LittleMoon9Sun/Pico-16-Key-Hitbox/亚克力外壳/加工说明.md

# 亚克力加工说明

请结合 `01_切割图_DWG` 内的图纸确认轮廓、开孔、铣槽及方向，正式加工前先核对比例和尺寸。

| 图纸 | 板材和工艺 |
| --- | --- |
| 01 | 4 mm，正面轻磨砂、背面透明；背面反印 UV，白墨打底。图中多数封闭矩形为开孔，其中一个指定方孔不切穿并保持透明、不喷绘；开孔有铣槽，具体区域请结合图纸与厂家确认。 |
| 02 | 4 mm 普通透明亚克力，图中框选区域正常开孔。 |
| 03 | 3 mm 普通透明亚克力，图中框选区域正常开孔。 |
| 04 | 2mm，发光板：参考 `05_发光板切割图.dwg`，选用透光扩散材料，厚度与叠层配合请先试装确认，使用前请核对轮廓、孔位和比例。 |
| 05 | 2 mm，正面透明磨砂，背面 UV 喷绘并白墨打底；图中框选区域正常开孔。 |

喷绘图案与开孔留白需另行提供并与厂家确认；本文不包含喷绘素材；使用前请核对轮廓、孔位和比例。

**本项目文件由 AI 协助整理，可能存在遗漏或错误，请在使用、加工或制作前自行审核并核对相关内容。**
