LittleMoon9Sun/Pico-16-Key-Hitbox/说明文档/开源协议说明.md

# 使用许可说明

本项目中作者有权授权的 PCB 设计、亚克力外壳设计及说明文档采用 **CC BY-NC 4.0（署名—非商业性使用 4.0 国际许可协议）**。完整法律条款见 [Creative Commons 官方协议](https://creativecommons.org/licenses/by-nc/4.0/legalcode.en)，中文概要见[协议说明](https://creativecommons.org/licenses/by-nc/4.0/deed.zh-hans)。

在遵守协议的前提下，使用者可以为非商业目的复制、分享和修改这些文件。分享时应合理署名、提供许可链接，并注明是否修改。商业使用需要另行取得权利人的许可。改编作品不强制采用相同许可，但原作品仍受其原有许可条件约束。

## 第三方内容

- PCB 工程包含动漫人物丝印；第三方插画及其他非作者拥有授权权利的内容不属于上述许可范围。使用这些内容还需取得相应权利人的许可。
- 喷绘图、动漫插图和启动图素材不属于本项目提供的授权素材。
- GP2040-CE 是独立项目，固件及其源码遵循[官方项目](https://github.com/OpenStickCommunity/GP2040-CE)的许可，本项目不重新授权。

本许可不赋予作者无权授权的权利，也不授予专利或商标权。涉及第三方素材的文件能否公开、复制或用于制板，应根据实际授权确认；仅将素材排除在许可之外，并不等于获得公开传播它的许可。

本项目采用非商业限制，属于供非商业用途的公开分享，不符合 [OSHWA 的开源硬件定义](https://oshwa.org/definition/)中允许商业使用的要求。
