LittleMoon9Sun/Pico-16-Key-Hitbox/说明文档/材料与成本.md

# 材料与成本参考

下表为制作时记录的采购规格与金额，单位均为人民币（元）。不同时间、购买数量、型号、优惠券和运费都会使价格变化；表中仅供复刻时估算和查找规格，并非实时售价或每台的固定成本。

**本项目文件由 AI 协助整理，可能存在遗漏或错误，请在使用、加工或制作前自行审核并核对相关内容。**

## 组装材料

| 类别 | 规格或型号 | 装机数量 | 采购数量 | 记录金额 | 备注 |
| --- | --- | ---: | ---: | ---: | --- |
| 主控 | Raspberry Pi Pico（RP2040） | 1 | 1 | 13.00 | 另有运费 3 元 |
| 轴体 | 凯华知春 CHOC 矮轴 | 16 | 18 | 53.50 | 多购 2 颗作备件 |
| 轴座 | 凯华 CHOC 热插拔底座 | 16 | 20 | 10.00 | 多购 4 个作备件 |
| RGB 灯 | 3528 反贴 RGB 灯珠 | 64 | 100 | 9.00 | 灯珠方向与串接顺序需实测 |
| 显示屏 | 0.96 英寸 128×64 OLED | 1 | 1 | 9.48 | I²C：SDA/GP0、SCL/GP1 |
| 轻触开关 | 6×6×9 mm、4 脚直插 | 5 | 20 | 2.20 | 另配 8×8 mm 硅胶帽 |
| 轻触开关帽 | 8×8 mm 硅胶按键帽 | 5 | 6 | 7.10 | 另有运费 5 元 |
| 电阻 | 22 Ω、0805 | 2 | 100 | 3.30 | USB 数据线串联位置；22 Ω 为阻值，0805 为封装 |
| 键帽 | 键帽 | 16 | 16 | 59.00 | 实际装配选更便宜键盘，另有运费 10 元 |
| 结构件 | 304 子母铆钉 M4×15 | 按装配需要 | 20 | 2.53 | 长度应和板材叠层实物核对 |
| PCB | 定制 PCB | 1 套 | 3 块 | 12.40 | **3 块合计，使用新人优惠券；无优惠券不能按此价格估算** |
| 外壳 | 亚克力板件 | 1 套 | 1 批 | 130.00 | 见 `亚克力外壳/加工说明.md` |
| 发光层 | 扩散板/发光板材料 | 1 套 | 1 批 | 15.00 | 厚度须与实物装配确认 |
| 线材 | Type-C 数据线 | 1 | 1 | 15.80 | 用于连接主控 |

## 制作工具与耗材

| 项目 | 规格 | 记录金额 |
| --- | --- | ---: |
| 按键分布打印 | ×2 | 0.40 |
| 电烙铁 | 60 W 内热式 | 34.80 |
| 焊锡丝 | 63Sn37Pb，50 g | 15.90 |
| 助焊膏 | 维修佬 559 | 8.68 |
| 洗板水 | — | 12.70 |
| 焊接练习件 | — | 14.68 |
| 隔热垫 | — | 7.51 |
| 镊子 | — | 2.89 |

## 估算口径

| 口径 | 金额 | 包含内容 |
| --- | ---: | --- |
| 表内全部历史记录 | 473.07 | 全部内容 |
| 可复用工具与耗材 | 97.56 | 电烙铁、焊锡、助焊膏、洗板水、练习件、隔热垫、镊子与打印费 |

实际复刻时，先按“板上/装配材料”逐项下单，再按是否已有工具决定是否加入第三项。PCB 的 12.40 元是三块板的优惠价，不能用它代表单块或常规制板价格。

**本项目文件由 AI 协助整理，可能存在遗漏或错误，请在使用、加工或制作前自行审核并核对相关内容。**
