LittleMoon9Sun/Pico-16-Key-Hitbox/(list of files, cad)

Other CAD files:
亚克力外壳/01_切割图_DWG/04_2MM发光板切割图.dwg
亚克力外壳/02_3D结构模型_DWG/01-3D顶板-最上层-铣槽版.dwg
亚克力外壳/01_切割图_DWG/02 4MM普通透明亚克力.dwg
亚克力外壳/02_3D结构模型_DWG/02-3D顶板-限位板.dwg
亚克力外壳/01_切割图_DWG/05 2MM正面透明磨砂背面UV喷涂白墨打底 亚克力.dwg
亚克力外壳/02_3D结构模型_DWG/04-3D底板-发光板.dwg
亚克力外壳/01_切割图_DWG/01 4MM正面轻磨砂背面透明反印UV喷涂白墨打底 亚克力（有铣槽和喷绘留白特殊需求）.dwg
亚克力外壳/02_3D结构模型_DWG/05-3D底板-最下层.dwg
亚克力外壳/01_切割图_DWG/03 3MM普通透明亚克力.dwg
亚克力外壳/02_3D结构模型_DWG/03-3D底板-PCB下层.dwg
