LittleMoon9Sun/Pico-16-Key-Hitbox/电路板/03_PCB布局预览_PDF/Hitbox_PCB布局预览1.pdf

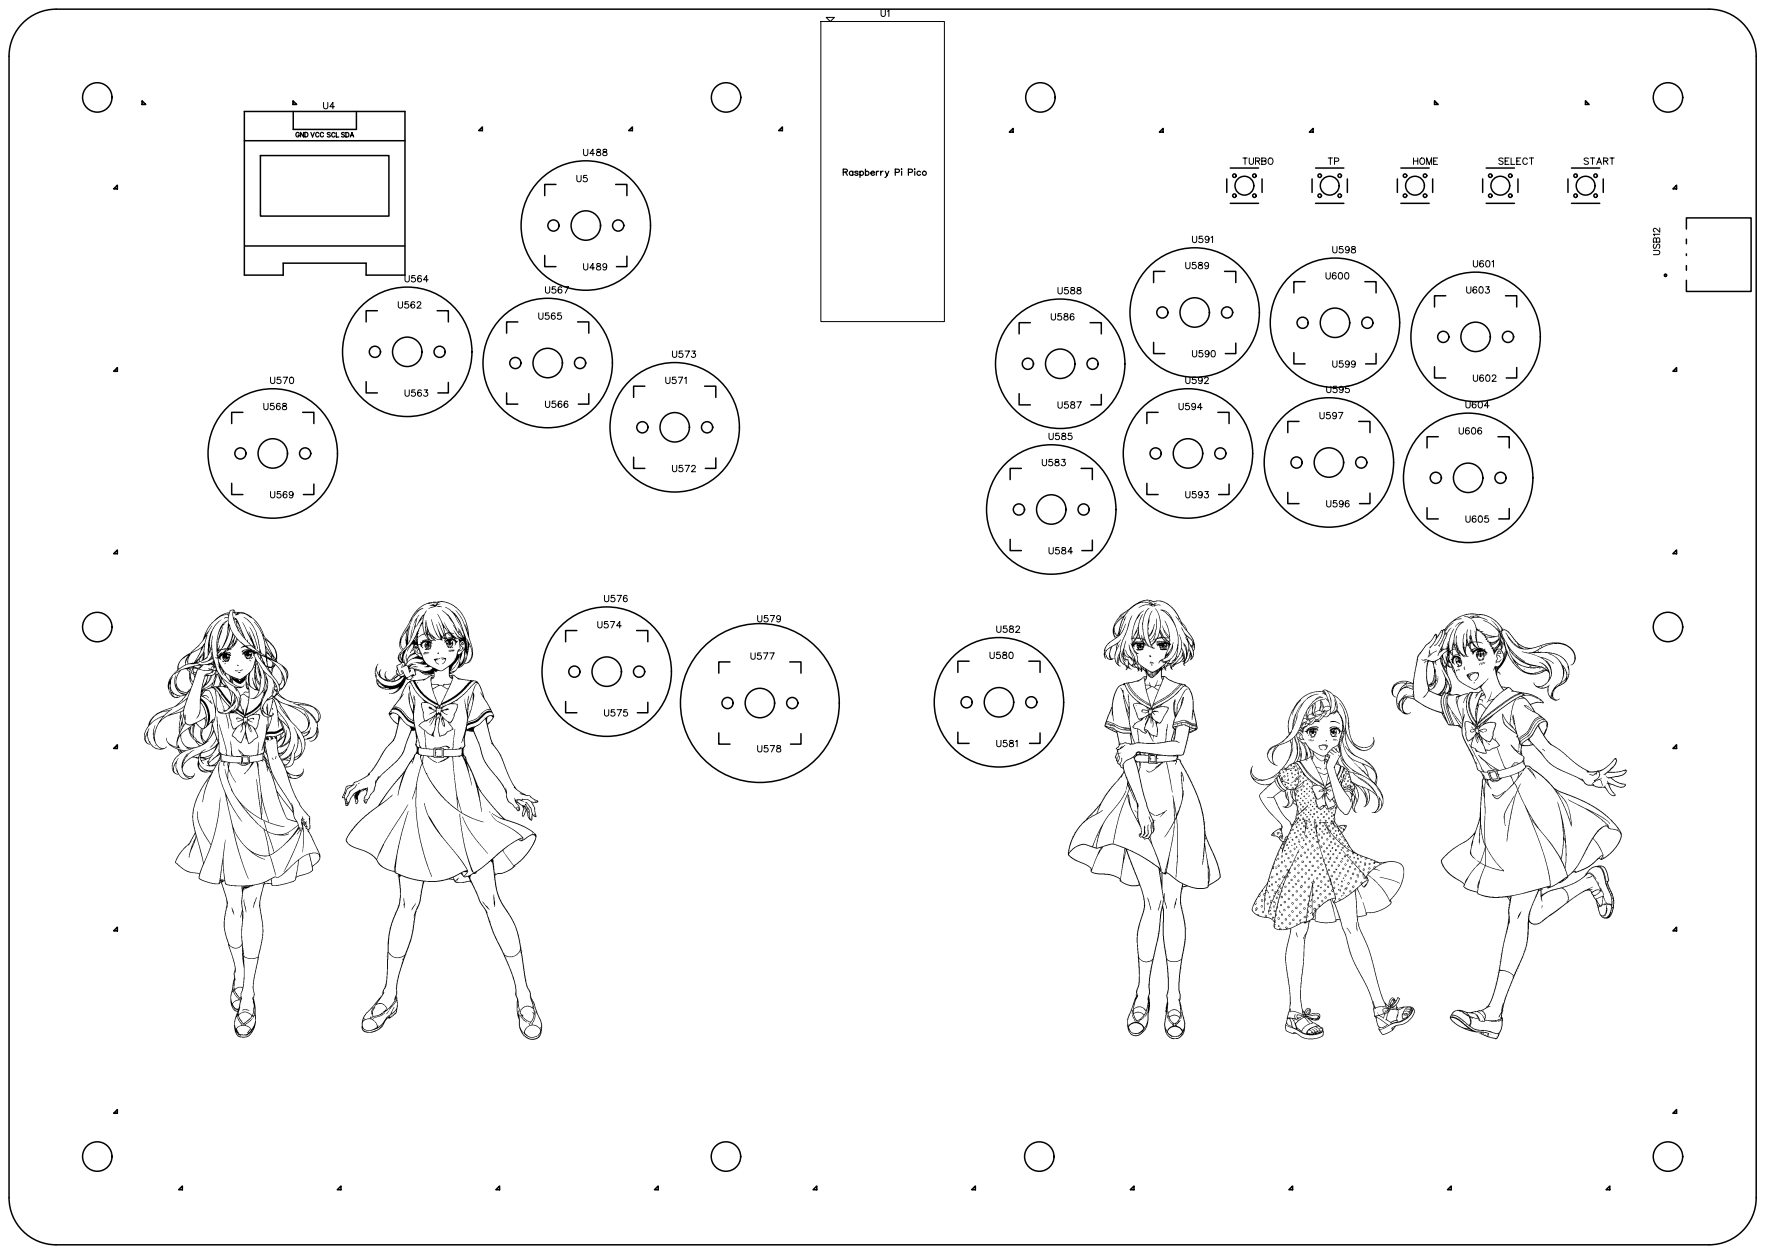
[picture p2: page 1]
