LittleMoon9Sun/Pico-16-Key-Hitbox/电路板/03_PCB布局预览_PDF/Hitbox_PCB布局预览2.pdf

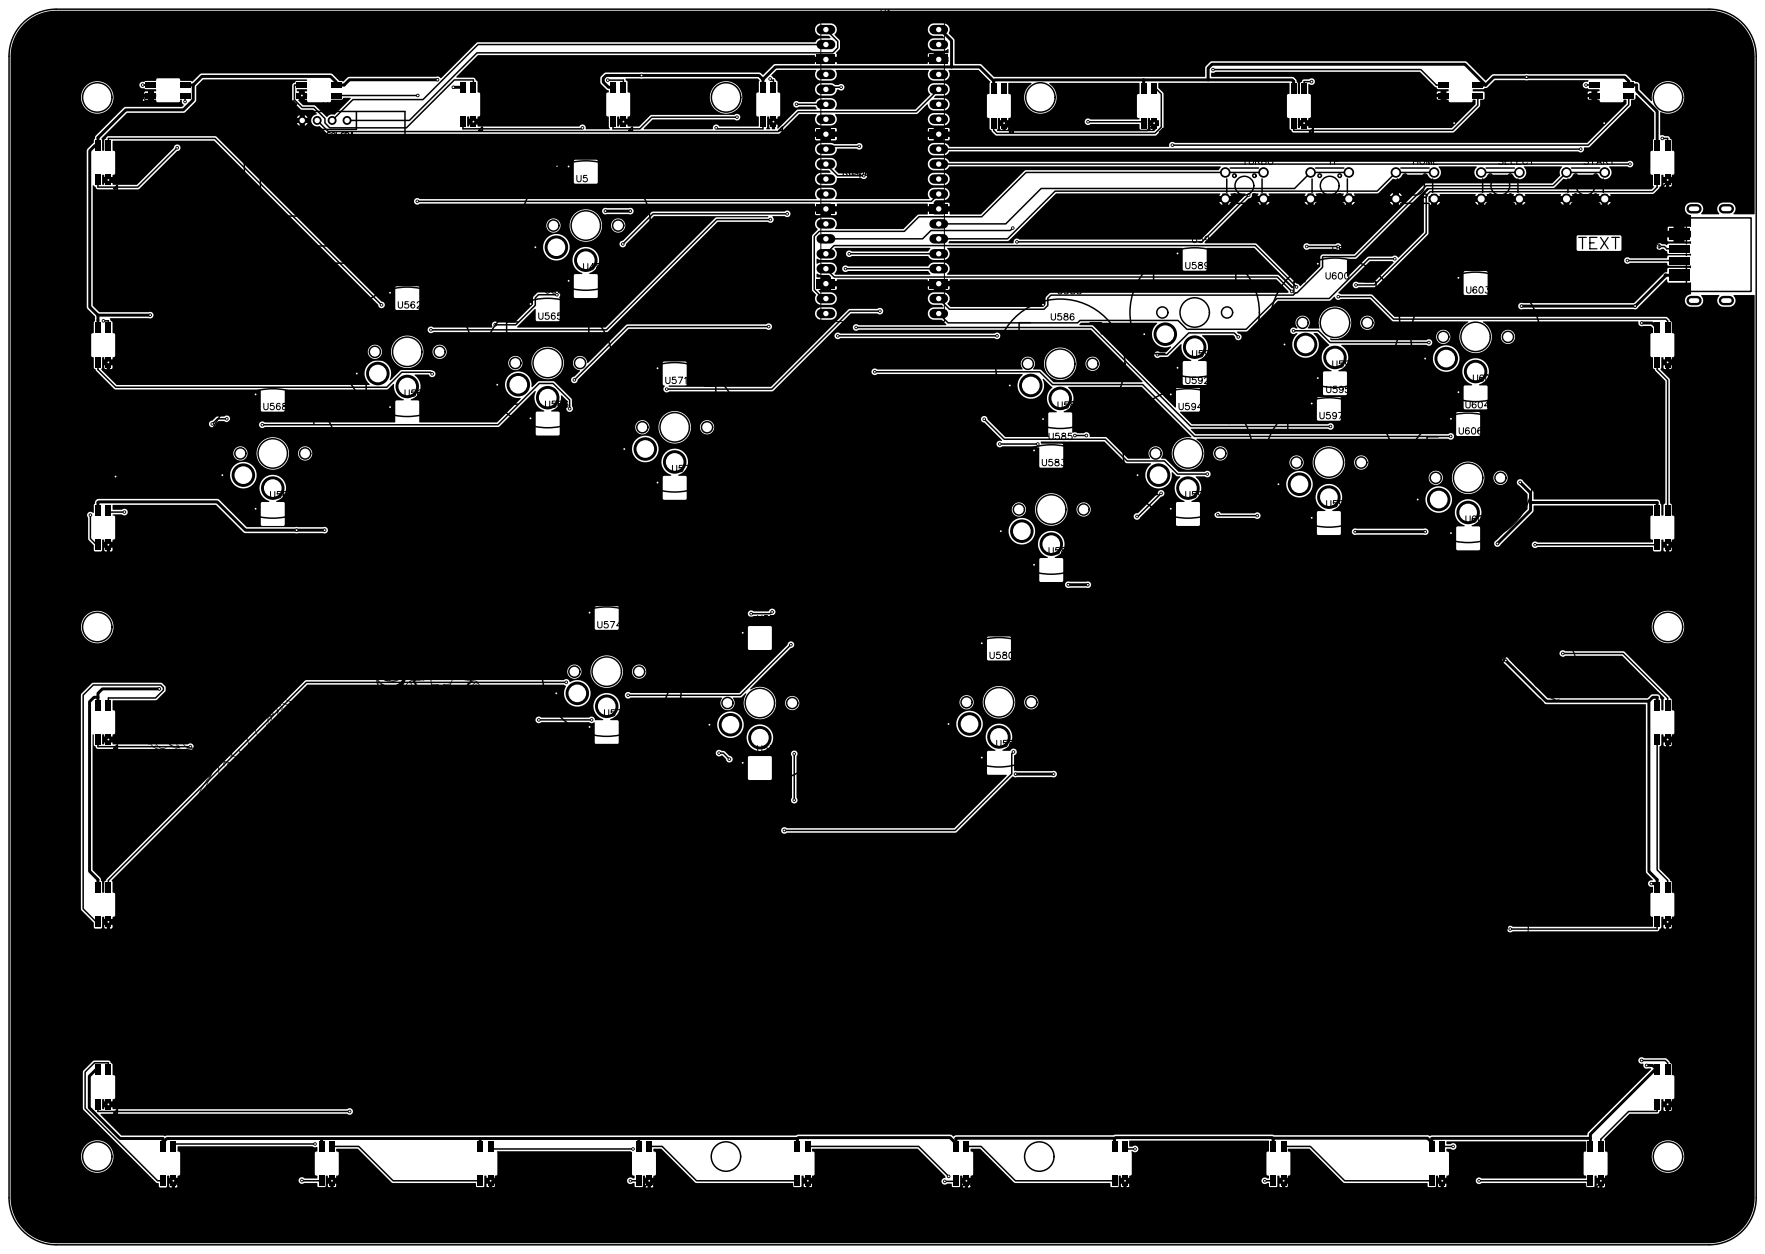
[picture p3: page 1]
