LittleMoon9Sun/Pico-16-Key-Hitbox/(commit log)

2026-11-02 发布 Hitbox 设计资料
    [01 4MM正面轻磨砂背面透明反印UV喷涂白墨打底 亚克力（有铣槽和喷绘留白特殊需求）.dwg, 01-3D顶板-最上层-铣槽版.dwg, 02 4MM普通透明亚克力.dwg, 02-3D顶板-限位板.dwg, 03 3MM普通透明亚克力.dwg, 03-3D底板-PCB下层.dwg, 04-3D底板-发光板.dwg, 04_2MM发光板切割图.dwg]
2026-11-02 补充面板图致谢
